sunyao-mmm/pynq-ecg-monitor/src/README.md

# Source

| 目录 | 用途 |
|---|---|
| `rtl/` | Verilog RTL 设计源码、AXI 寄存器、ADS1292 驱动和 XDC 约束 |

板端 Python 脚本放在 `board/`，仿真文件放在 `sim/`，避免把运行代码和 RTL 混在一起。
