sunyao-mmm/pynq-ecg-monitor/report/README.md

# Report

| 文件或目录 | 用途 |
|---|---|
| `design_report.docx` | 作品设计报告 |
| `ai_collaboration_source.md` | 大模型协作复盘、脱敏提示词、模型判断和人工验证摘录 |
| `evidence_appendix.md` | 测试矩阵、优化前后对比、时延拆分和 MIT-BIH 排除说明 |
| `performance/` | 时序、资源、检测和实时结果汇总 |
