sunyao-mmm/pynq-ecg-monitor/data/README.md

# Data

| 目录 | 用途 |
|---|---|
| `rom/` | 15 个 MIT-BIH 1024×16 COE、默认 208 的 HEX 回归文件、ROM 说明和生成脚本 |
| `mitbih/` | 批量验证脚本、运行日志和 Se/PPV 结果 |

`rom/` 用于 Vivado Block Memory Generator 初始化；`mitbih/` 用于算法离线验证，两者使用相同的数据缩放和重采样规则。
