sunyao-mmm/pynq-ecg-monitor/skill/vivado-report-audit/README.md

# Vivado Report Audit

| 文件或目录 | 用途 |
|---|---|
| `SKILL.md` | 适用场景、命令、验证结果和失效条件 |
| `scripts/check_reports.py` | 解析 timing/util 报告并输出 PASS/FAIL |
