sunyao-mmm/pynq-ecg-monitor/skill/fpga-agent-workflow/README.md

# FPGA Agent Workflow

| 文件或目录 | 用途 |
|---|---|
| `SKILL.md` | 人机协作调试的核心循环、适用边界和已验证效果 |
| `references/` | 提示词、案例模板和常见错误清单 |
