sunyao-mmm/pynq-ecg-monitor/skill/golden-signal-compare/README.md

# Golden Signal Compare

| 文件或目录 | 用途 |
|---|---|
| `SKILL.md` | 适用场景、容差规则、验证结果和失效条件 |
| `scripts/compare_intervals.py` | 对参考事件和检测事件做一对一匹配并计算 Se/PPV |
| `examples/` | record 100 的参考和检测峰值样例 |
