sunyao-mmm/pynq-ecg-monitor/skill/vivado-report-audit/scripts/README.md

# Scripts

| 文件 | 用途 |
|---|---|
| `check_reports.py` | 提取 WNS、WHS、失败端点、LUT、BRAM、DSP，并按阈值判断 |

最小示例见上级 `SKILL.md`。
