sunyao-mmm/pynq-ecg-monitor/skill/fpga-agent-workflow/references/README.md

# References

| 文件 | 用途 |
|---|---|
| `prompts.md` | 现象定位、版本差异、时序分析和输出验收提示词 |
| `case_template.md` | 一次问题从现象到回归的可复用记录模板 |
| `pitfalls.md` | FPGA/PYNQ 常见症状、优先检查和验证方法 |
