sunyao-mmm/pynq-ecg-monitor/skill/golden-signal-compare/scripts/README.md

# Scripts

| 文件 | 用途 |
|---|---|
| `compare_intervals.py` | 读取整数事件列表，在给定容差内做贪心一对一匹配 |

输入文件支持每行一个整数或逗号分隔整数。
