sunyao-mmm/pynq-ecg-monitor/skill/pynq-overlay-smoke/examples/README.md

# Examples

| 文件 | 用途 |
|---|---|
| `register_map.json` | `ecg_axil_0` 的寄存器偏移、期望 ID、测试值和运行位示例 |
| `minimal_register_map.json` | 非心电 AXI-Lite 项目的最小 SCRATCH 回读示例 |
| `validation_output.txt` | 无板卡模拟后端测试的原始通过输出 |

换项目时只修改 IP 名称和 JSON 中的寄存器描述，不需要改 Python 脚本。
