sunyao-mmm/pynq-ecg-monitor/skill/pynq-overlay-smoke/references/README.md

# References

| 文件 | 用途 |
|---|---|
| `troubleshooting.md` | 按症状列出 Overlay、IP、地址、时钟、复位和缓存问题的检查方法 |
