sunyao-mmm/pynq-ecg-monitor/report/performance/README.md

# Performance

| 文件 | 用途 |
|---|---|
| `performance_summary.md` | WNS/WHS、LUT/FF/BRAM/DSP、连续缓存、网页逻辑、MIT-BIH 和功能验证汇总 |
