sunyao-mmm/pynq-ecg-monitor/data/mitbih/verification_results.md

| 记录 | 标注心搏 | 检出TP | 漏检FN | 误检FP | Se(%) | PPV(%) | 参考时间轴可信 |
|---|---|---|---|---|---|---|---|
| 100 | 2273 | 2273 | 0 | 0 | 100.00 | 100.00 | ✅ |
| 101 | 1865 | 1861 | 4 | 6 | 99.79 | 99.68 | ✅ |
| 103 | 2084 | 2084 | 0 | 1 | 100.00 | 99.95 | ✅ |
| 105 | 2572 | 2557 | 15 | 14 | 99.42 | 99.46 | ✅ |
| 108 | 1763 | 1542 | 221 | 316 | 87.46 | 82.99 | ✅ |
| 111 | 2124 | 2121 | 3 | 4 | 99.86 | 99.81 | ✅ |
| 112 | 2539 | 2537 | 2 | 2 | 99.92 | 99.92 | ✅ |
| 114 | 643 | 128 | 515 | 1760 | 19.91 | 6.78 | ❌ 仅列出 |
| 116 | 2412 | 2393 | 19 | 3 | 99.21 | 99.87 | ✅ |
| 117 | 1535 | 1535 | 0 | 0 | 100.00 | 100.00 | ✅ |
| 118 | 2278 | 2274 | 4 | 5 | 99.82 | 99.78 | ✅ |
| 119 | 1987 | 1967 | 20 | 22 | 98.99 | 98.89 | ❌ 仅列出 |
| 121 | 1863 | 1853 | 10 | 12 | 99.46 | 99.36 | ❌ 仅列出 |
| 122 | 2476 | 2475 | 1 | 1 | 99.96 | 99.96 | ✅ |
| 123 | 1518 | 1516 | 2 | 1 | 99.87 | 99.93 | ✅ |
| 200 | 1565 | 780 | 785 | 1821 | 49.84 | 29.99 | ❌ 仅列出 |
| 208 | 2955 | 2737 | 218 | 30 | 92.62 | 98.92 | ✅ |
| 220 | 693 | 509 | 184 | 1534 | 73.45 | 24.91 | ❌ 仅列出 |
| 223 | 1689 | 1181 | 508 | 1422 | 69.92 | 45.37 | ❌ 仅列出 |
| 228 | 2053 | 1997 | 56 | 94 | 97.27 | 95.50 | ✅ |
| 230 | 797 | 227 | 570 | 2029 | 28.48 | 10.06 | ❌ 仅列出 |
| 233 | 2033 | 961 | 1072 | 2007 | 47.27 | 32.38 | ❌ 仅列出 |
| 234 | 2309 | 1750 | 559 | 999 | 75.79 | 63.66 | ❌ 仅列出 |
| **合计（仅可信记录）** | 30447 | 29902 | 545 | 477 | **98.21** | **98.43** | |
