sunyao-mmm/pynq-ecg-monitor/sim/testbench/tb_ecg_core.v

`timescale 1ns / 1ps
`default_nettype none
//==========================================================================
// tb_ecg_core.v -- round 1 of phase 2-2: the real ecg_core (ROM player + FIR
//                 + CLT + heart rate) driven with the 1024 MIT-BIH samples.
//
//   A behavioural ROM with 1 clock read latency stands in for the Block Memory
//   Generator that will sit in the block design.
//
//   expected: R peaks at input indices 77 / 370 / 663 / 947
//             bpm = 74 / 74 / 76 ,  beat_count = 4
//
//   CLK_PER_SAMPLE is set to 64 here (the board uses 277778) so the run is short.
//   ASCII only on purpose.
//==========================================================================
module tb_ecg_core;

    localparam integer NSAMP = 711;
    localparam integer CLKS  = 64;          // clocks per sample in this simulation

    reg clk = 1'b0;
    always #5 clk = ~clk;                   // 100 MHz

    reg  rst_n, run, soft_rst;
    reg  [31:0] cap_len_in;
    reg         src_sel;
    reg  signed [15:0] adc_sample;
    reg         adc_valid;
    wire [9:0]  rom_addr;
    reg  signed [15:0] rom_data;
    wire        cap_we;
    wire [11:0] cap_addr;
    wire [31:0] cap_data;
    wire [31:0] st_clt_now, st_r_index, st_rr_samples, st_beat_count, st_rr_bad_cnt;
    wire [15:0] st_r_amp, st_bpm;
    wire        st_cap_done;

    reg signed [15:0] mem [0:NSAMP-1];      // the behavioural ROM contents

    integer i, n_det, n_bpm, errs, checks;
    reg [31:0] det [0:31];
    reg [15:0] bpm_seen [0:7];
    integer exp_det [0:3];
    integer exp_bpm [0:3];

    // ---- behavioural ROM with 2 clock read latency (this is what the BMG
    //      summary reports, so we verify the worst case here) ----
    reg signed [15:0] rom_q1;
    always @(posedge clk) begin
        rom_q1   <= mem[rom_addr];
        rom_data <= rom_q1;
    end

    ecg_core #(.CLK_PER_SAMPLE(CLKS), .ROM_AW(10), .CAP_AW(12), .ROM_LEN(711), .SETTLE(0), .CAL_FIRST(0)) dut (
        .clk(clk), .rst_n(rst_n), .run(run), .soft_rst(soft_rst), .cap_len_in(cap_len_in),
        .src_sel(src_sel), .adc_sample(adc_sample), .adc_valid(adc_valid),
        .rom_addr(rom_addr), .rom_data(rom_data),
        .cap_we(cap_we), .cap_addr(cap_addr), .cap_data(cap_data),
        .st_clt_now(st_clt_now), .st_r_index(st_r_index), .st_r_amp(st_r_amp), .st_bpm(st_bpm),
        .st_rr_samples(st_rr_samples), .st_beat_count(st_beat_count),
        .st_rr_bad_cnt(st_rr_bad_cnt), .st_cap_done(st_cap_done)
    );

    // ---- the testbench acts like the ARM: it samples the status ports ----
    reg        clt_valid_d;
    reg        r_valid_d;      // r_valid one clock earlier (the cycle that was captured)

    // ---- capture format monitor: TWO 32-bit words per sample ----------------
    //   even word address : { 15'b0, r_valid, y[15:0] }   band-passed ECG + R flag
    //   odd  word address : clt_out                       CLT value
    integer cap_we_cnt, cap_w0_cnt, cap_w1_cnt, cap_clt_cnt, cap_fmt_errs;
    always @(posedge clk) begin
        clt_valid_d <= cap_we;                      // one capture write pulse
        r_valid_d   <= dut.u_det.r_valid;           // the flag that is being captured
        if (rst_n && dut.u_det.clt_valid) cap_clt_cnt = cap_clt_cnt + 1;
        if (rst_n && cap_we) begin
            cap_we_cnt = cap_we_cnt + 1;
            // NOTE: cap_we / cap_addr / cap_data are all registered on the same
            // edge, so the address seen here is already the NEXT one.  The word
            // that was just written therefore sits at (cap_addr - 1), i.e. the
            // waveform word shows up here when cap_addr is ODD.
            if (cap_addr[0] == 1'b1) begin          // waveform word (addr-1 even)
                cap_w0_cnt = cap_w0_cnt + 1;
                if (cap_data[15:0] !== dut.u_det.y) begin
                    cap_fmt_errs = cap_fmt_errs + 1;
                    if (cap_fmt_errs < 4)
                        $display("  FAIL capture wave word: got %0d  y = %0d",
                                 cap_data[15:0], dut.u_det.y);
                end
                if (cap_data[16] !== r_valid_d) begin
                    cap_fmt_errs = cap_fmt_errs + 1;
                    if (cap_fmt_errs < 4)
                        $display("  FAIL capture R flag: got %0d  r_valid = %0d",
                                 cap_data[16], r_valid_d);
                end
            end
            else begin                              // CLT word (addr-1 odd)
                cap_w1_cnt = cap_w1_cnt + 1;
                // 2026-10-18: CLT 字的最高字节现在放 LOFF_STAT（bit31 恒为 1），
                // 比较时只看低 24 位。
                if ((cap_data & 32'h00FF_FFFF) !== (dut.u_det.clt_out & 32'h00FF_FFFF)) begin
                    cap_fmt_errs = cap_fmt_errs + 1;
                    if (cap_fmt_errs < 4)
                        $display("  FAIL capture CLT word: got %0d  clt = %0d",
                                 cap_data, dut.u_det.clt_out);
                end
            end
        end
    end

    // monitor: catch the R peaks and the bpm updates the same way the PS would
    reg r_valid_prev;
    always @(posedge clk) r_valid_prev <= dut.u_det.r_valid;
    always @(posedge clk) begin
        if (rst_n && !r_valid_prev && dut.u_det.r_valid && n_det < 32) begin
            det[n_det] = dut.u_det.r_index;
            $display("  [%0t] R peak: index=%0d  amp=%0d", $time, dut.u_det.r_index, dut.u_det.r_amp);
            n_det = n_det + 1;
        end
        if (rst_n && dut.u_hr.bpm_valid && n_bpm < 8) begin
            bpm_seen[n_bpm] = dut.u_hr.bpm;
            $display("  [%0t] bpm = %0d   (rr = %0d samples)", $time, dut.u_hr.bpm, dut.u_hr.rr_samples);
            n_bpm = n_bpm + 1;
        end
    end

    task clear_stats;
        begin
            n_det = 0; n_bpm = 0;
            cap_we_cnt = 0; cap_w0_cnt = 0; cap_w1_cnt = 0;
            cap_clt_cnt = 0; cap_fmt_errs = 0;
            for (i = 0; i < 32; i = i + 1) det[i] = 32'd0;
            for (i = 0; i < 8;  i = i + 1) bpm_seen[i] = 16'd0;
        end
    endtask

    task check_all;
        integer k;
        begin
            $display("detected %0d R peaks (expect 4)", n_det);
            for (k = 0; k < 4; k = k + 1) begin
                checks = checks + 1;
                if (k < n_det && ($signed(det[k]) - $signed(exp_det[k])) <= 2 && ($signed(exp_det[k]) - $signed(det[k])) <= 2) $display("  ok   R peak[%0d] = %0d", k, det[k]);
                else begin
                    errs = errs + 1;
                    $display("  FAIL R peak[%0d] = %0d   (expect %0d)", k, det[k], exp_det[k]);
                end
            end
            $display("bpm updates: %0d (expect 3)", n_bpm);
            for (k = 0; k < 3; k = k + 1) begin
                checks = checks + 1;
                if (k < n_bpm && bpm_seen[k] === exp_bpm[k]) $display("  ok   bpm[%0d] = %0d", k, bpm_seen[k]);
                else begin
                    errs = errs + 1;
                    $display("  FAIL bpm[%0d] = %0d   (expect %0d)", k, bpm_seen[k], exp_bpm[k]);
                end
            end
            checks = checks + 1;
            if (st_beat_count === 32'd4) $display("  ok   st_beat_count = 4");
            else begin errs = errs + 1; $display("  FAIL st_beat_count = %0d (expect 4)", st_beat_count); end

            checks = checks + 1;
            if (($signed(st_rr_samples) - $signed(exp_det[3]-exp_det[2])) <= 2 && ($signed(exp_det[3]-exp_det[2]) - $signed(st_rr_samples)) <= 2) $display("  ok   st_rr_samples = %0d (last RR)", st_rr_samples);
            else begin errs = errs + 1; $display("  FAIL st_rr_samples = %0d (expect %0d)", st_rr_samples, exp_det[3]-exp_det[2]); end

            checks = checks + 1;
            if (st_cap_done === 1'b0) $display("  ok   st_cap_done = 0 (capture still running, buffer 4096 > 711)");
            else begin errs = errs + 1; $display("  FAIL st_cap_done = %0d", st_cap_done); end

            // ---- capture buffer format: 2 words per sample ----
            checks = checks + 1;
            if (cap_fmt_errs == 0 && cap_w0_cnt == cap_w1_cnt &&
                cap_we_cnt == 2*cap_clt_cnt && cap_w0_cnt > 0)
                $display("  ok   capture = %0d wave + %0d CLT words for %0d samples",
                         cap_w0_cnt, cap_w1_cnt, cap_clt_cnt);
            else begin
                errs = errs + 1;
                $display("  FAIL capture: we=%0d w0=%0d w1=%0d clt=%0d fmterr=%0d",
                         cap_we_cnt, cap_w0_cnt, cap_w1_cnt, cap_clt_cnt, cap_fmt_errs);
            end
        end
    endtask

    initial begin
        exp_det[0] = 54;  exp_det[1] = 258; exp_det[2] = 461; exp_det[3] = 658;
    // 2026-10-18: bpm 改为"最近 4 拍 RR 的中位数"，最后一拍 203->197 的小变化
    // 会被中位数平滑掉，读数是 74 而不是 76。这是预期的滤波行为。
    exp_bpm[0] = 74;  exp_bpm[1] = 74;  exp_bpm[2] = 74;  exp_bpm[3] = -1;

        mem[0] = -32'sd145;
        mem[1] = -32'sd145;
        mem[2] = -32'sd145;
        mem[3] = -32'sd145;
        mem[4] = -32'sd145;
        mem[5] = -32'sd145;
        mem[6] = -32'sd120;
        mem[7] = -32'sd145;
        mem[8] = -32'sd150;
        mem[9] = -32'sd160;
        mem[10] = -32'sd160;
        mem[11] = -32'sd175;
        mem[12] = -32'sd185;
        mem[13] = -32'sd170;
        mem[14] = -32'sd175;
        mem[15] = -32'sd180;
        mem[16] = -32'sd180;
        mem[17] = -32'sd155;
        mem[18] = -32'sd135;
        mem[19] = -32'sd190;
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
        mem[663] = -32'sd475;
        mem[664] = -32'sd390;
        mem[665] = -32'sd390;
        mem[666] = -32'sd410;
        mem[667] = -32'sd405;
        mem[668] = -32'sd385;
        mem[669] = -32'sd395;
        mem[670] = -32'sd405;
        mem[671] = -32'sd405;
        mem[672] = -32'sd400;
        mem[673] = -32'sd395;
        mem[674] = -32'sd410;
        mem[675] = -32'sd410;
        mem[676] = -32'sd395;
        mem[677] = -32'sd405;
        mem[678] = -32'sd405;
        mem[679] = -32'sd405;
        mem[680] = -32'sd390;
        mem[681] = -32'sd385;
        mem[682] = -32'sd395;
        mem[683] = -32'sd400;
        mem[684] = -32'sd400;
        mem[685] = -32'sd395;
        mem[686] = -32'sd395;
        mem[687] = -32'sd405;
        mem[688] = -32'sd400;
        mem[689] = -32'sd385;
        mem[690] = -32'sd375;
        mem[691] = -32'sd395;
        mem[692] = -32'sd390;
        mem[693] = -32'sd385;
        mem[694] = -32'sd385;
        mem[695] = -32'sd395;
        mem[696] = -32'sd385;
        mem[697] = -32'sd375;
        mem[698] = -32'sd385;
        mem[699] = -32'sd395;
        mem[700] = -32'sd390;
        mem[701] = -32'sd365;
        mem[702] = -32'sd375;
        mem[703] = -32'sd395;
        mem[704] = -32'sd380;
        mem[705] = -32'sd375;
        mem[706] = -32'sd380;
        mem[707] = -32'sd380;
        mem[708] = -32'sd375;
        mem[709] = -32'sd375;
        mem[710] = -32'sd375;

        rst_n = 1'b0; run = 1'b0; soft_rst = 1'b0; cap_len_in = 32'd4096;
        src_sel = 1'b0; adc_sample = 16'sd0; adc_valid = 1'b0;
        errs = 0; checks = 0;
        clear_stats;

        repeat (5) @(negedge clk);
        rst_n = 1'b1;
        repeat (3) @(negedge clk);
        run = 1'b1;

        $display("========== ecg_core : dual data source (ROM / ADS1292) ==========");
        $display("*** TB BUILD CORE-2 ***  (711 samples inlined, no .hex file needed)");

        // ---- phase 0 : ROM player ----
        repeat (NSAMP*CLKS + 4000) @(posedge clk);
        run = 1'b0;                          // stop the sample stream so the
        repeat (8) @(posedge clk);           // capture counters settle mid-pair
        $display("--- source 0 : ROM player ---");
        check_all;

        // ---- phase 1 : the same samples pushed in through the ADS1292 port ----
        clear_stats;
        src_sel = 1'b1;
        soft_rst = 1'b1; repeat (5) @(negedge clk); soft_rst = 1'b0;
        repeat (3) @(negedge clk);
        run = 1'b1;
        // 64 extra samples wrap round like the real ROM loop, so the last beat's
        // CLT can finish falling below half peak.
        for (i = 0; i < NSAMP+64; i = i + 1) begin
            @(negedge clk); adc_sample = (i < NSAMP) ? mem[i] : mem[i-NSAMP]; adc_valid = 1'b1;
            @(negedge clk); adc_valid = 1'b0;
            repeat (CLKS-2) @(negedge clk);
        end
        repeat (4000) @(posedge clk);
        run = 1'b0;
        repeat (8) @(posedge clk);
        $display("--- source 1 : ADS1292 port ---");
        check_all;

        $display("---------------------------------------------------------------------------");
        $display("checks = %0d   errors = %0d", checks, errs);
        if (errs == 0) $display("  RESULT: PASS");
        else           $display("  RESULT: FAIL");
        $display("===========================================================================");
        $finish;
    end

endmodule
`default_nettype wire
