sunyao-mmm/pynq-ecg-monitor/sim/testbench/tb_ecg_detect.v

`timescale 1ns / 1ps
`default_nettype none
//==========================================================================
// tb_ecg_detect.v -- self checking testbench for the FIR + CLT chain   (ECG-1)
//
//   input : 1024 samples of MIT-BIH record 100, lead MLII, inlined below
//           (uV, exactly the values of Desktop/ecg.coe)
//   truth : the MIT-BIH annotations inside that window: 77 / 370 / 662 / 946
//   each sample is applied with a 1 clock ce pulse every 64 clocks, so the
//   serial FIR (33 clocks) has plenty of time - just like the real 360 Hz rate.
//
//   expected result: 4 peaks detected, TP=4 FP=0 FN=0, and 960 y_valid pulses
//   (65 tap FIR -> the first 64 outputs are the start-up transient)
//
//   ASCII only on purpose.
//==========================================================================
module tb_ecg_detect;

    localparam integer NSAMP            = 775;
    localparam integer NTRUTH           = 4;
    localparam integer TOL              = 10;
    localparam integer CLKS_PER_SAMPLE  = 64;

    reg clk = 1'b0;
    always #5 clk = ~clk;                  // 100 MHz

    reg                rst_n;
    reg                ce;
    reg  signed [15:0] x;
    wire signed [15:0] y;
    wire               y_valid;
    wire signed [31:0] clt_out;
    wire               clt_valid;
    wire               r_valid;
    wire [31:0]        r_index;
    wire signed [15:0] r_amp;

    reg signed [15:0] stim  [0:NSAMP-1];
    integer           truth [0:NTRUTH-1];

    integer i, n_det, tp, fp, fn, n_yv, sei, ppvi;
    integer smin, smax;
    reg [31:0] det [0:63];
    reg        used [0:NTRUTH-1];
    reg [31:0] delta;
    reg        matched;
    reg signed [31:0] clt_max;

    ecg_detect_top #(
        .FIR_TAPS(65), .FIR_DELAY(32), .CLT_W(21), .C_CONST(2),
        .LEARN(30), .SEARCH(22), .REFRACT(50), .REL_PERIOD(250),
        .DATA_W(16), .ACC_W(32)
    ) dut (
        .clk(clk), .rst_n(rst_n), .ce(ce), .x(x), .settle_sel(16'd0), .cal_first(1'b0),
        .y(y), .y_valid(y_valid),
        .clt_out(clt_out), .clt_valid(clt_valid),
        .r_valid(r_valid), .r_index(r_index), .r_amp(r_amp)
    );

    always @(posedge clk) if (rst_n && y_valid) n_yv = n_yv + 1;
    always @(posedge clk) if (rst_n && clt_valid && (clt_out > clt_max)) clt_max = clt_out;

    always @(posedge clk) begin
        if (rst_n && r_valid && (n_det < 64)) begin
            det[n_det] = r_index;
            $display("  [%0t] R peak: input index=%0d  amp=%0d  clt=%0d",
                     $time, r_index, r_amp, clt_out);
            n_det = n_det + 1;
        end
    end

    initial begin
        rst_n = 1'b0; ce = 1'b0; x = 16'sd0;
        n_det = 0; tp = 0; fp = 0; fn = 0; n_yv = 0;
        clt_max = -1000000;
        for (i = 0; i < NTRUTH; i = i + 1) used[i] = 1'b0;
        for (i = 0; i < 64;     i = i + 1) det[i]  = 32'd0;

        // ---- stimulus inlined below: no .hex file needed ----
        stim[0] = -32'sd145;
        stim[1] = -32'sd145;
        stim[2] = -32'sd145;
        stim[3] = -32'sd145;
        stim[4] = -32'sd145;
        stim[5] = -32'sd145;
        stim[6] = -32'sd120;
        stim[7] = -32'sd145;
        stim[8] = -32'sd150;
        stim[9] = -32'sd160;
        stim[10] = -32'sd160;
        stim[11] = -32'sd175;
        stim[12] = -32'sd185;
        stim[13] = -32'sd170;
        stim[14] = -32'sd175;
        stim[15] = -32'sd180;
        stim[16] = -32'sd180;
        stim[17] = -32'sd155;
        stim[18] = -32'sd135;
        stim[19] = -32'sd190;
        stim[20] = -32'sd205;
        stim[21] = -32'sd225;
        stim[22] = -32'sd245;
        stim[23] = -32'sd260;
        stim[24] = -32'sd275;
        stim[25] = -32'sd275;
        stim[26] = -32'sd265;
        stim[27] = -32'sd255;
        stim[28] = -32'sd275;
        stim[29] = -32'sd290;
        stim[30] = -32'sd290;
        stim[31] = -32'sd290;
        stim[32] = -32'sd295;
        stim[33] = -32'sd305;
        stim[34] = -32'sd285;
        stim[35] = -32'sd275;
        stim[36] = -32'sd280;
        stim[37] = -32'sd305;
        stim[38] = -32'sd290;
        stim[39] = -32'sd280;
        stim[40] = -32'sd290;
        stim[41] = -32'sd315;
        stim[42] = -32'sd320;
        stim[43] = -32'sd335;
        stim[44] = -32'sd385;
        stim[45] = -32'sd385;
        stim[46] = -32'sd455;
        stim[47] = -32'sd485;
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
        stim[764] = -32'sd375;
        stim[765] = -32'sd375;
        stim[766] = -32'sd375;
        stim[767] = -32'sd375;
        stim[768] = -32'sd375;
        stim[769] = -32'sd375;
        stim[770] = -32'sd375;
        stim[771] = -32'sd375;
        stim[772] = -32'sd375;
        stim[773] = -32'sd375;
        stim[774] = -32'sd375;
        // ---- MIT-BIH annotations inside this window ----
        truth[0] = 32'sd53;
        truth[1] = 32'sd257;
        truth[2] = 32'sd460;
        truth[3] = 32'sd658;

        $display("=========== ecg_detect_top : FIR 5-40 Hz + CLT ===========");
        $display("*** TB BUILD ECG-1-3 ***  (1024 samples inlined, no .hex file needed)");
        smin = stim[0]; smax = stim[0];
        for (i = 0; i < NSAMP; i = i + 1) begin
            if (stim[i] < smin) smin = stim[i];
            if (stim[i] > smax) smax = stim[i];
        end
        $display("stimulus min/max = %0d / %0d   (expect -645 / 960)", smin, smax);
        $display("FIR group delay  = 32 input samples (88.9 ms), already added back into r_index");
        for (i = 0; i < NTRUTH; i = i + 1)
            $display("    truth[%0d] = %0d", i, truth[i]);

        repeat (10) @(negedge clk);
        rst_n = 1'b1;
        repeat (5) @(negedge clk);

        // Stimulus is driven on the FALLING edge, i.e. half a clock before the DUT
        // samples it.  Driving it on the rising edge (as the first version did) races
        // with the DUT sampling on that same edge: one simulator lets the testbench
        // win, another lets the DUT win.  ModelSim passed, xsim did not.
        for (i = 0; i < NSAMP; i = i + 1) begin
            @(negedge clk);
            x  = stim[i];
            ce = 1'b1;
            @(negedge clk);
            ce = 1'b0;
            repeat (CLKS_PER_SAMPLE-2) @(negedge clk);
        end
        repeat (200) @(posedge clk);

        // ---------------- score ----------------
        for (i = 0; i < n_det; i = i + 1) begin
            matched = 1'b0;
            for (fn = 0; fn < NTRUTH; fn = fn + 1) begin
                if (!matched && !used[fn]) begin
                    delta = (det[i] >= truth[fn]) ? (det[i] - truth[fn]) : (truth[fn] - det[i]);
                    if (delta <= TOL) begin
                        used[fn] = 1'b1; matched = 1'b1; tp = tp + 1;
                        $display("  TP: detected %0d  matched annotation %0d  (delta %0d)",
                                 det[i], truth[fn], delta);
                    end
                end
            end
            if (!matched) begin
                fp = fp + 1;
                $display("  FP: detected %0d has no annotation", det[i]);
            end
        end
        for (fn = 0; fn < NTRUTH; fn = fn + 1)
            if (!used[fn]) begin
                $display("  FN: missed annotation %0d", truth[fn]);
            end
        fn = 0;
        for (i = 0; i < NTRUTH; i = i + 1) if (!used[i]) fn = fn + 1;

        $display("-------------------------------------------------");
        $display("detected = %0d   annotations = %0d", n_det, NTRUTH);
        $display("TP = %0d   FP = %0d   FN = %0d", tp, fp, fn);
        if ((tp + fn) > 0) begin
            sei = (tp * 1000) / (tp + fn);
            $display("Se  (sensitivity) = %0d.%0d %%", sei/10, sei%10);
        end
        if ((tp + fp) > 0) begin
            ppvi = (tp * 1000) / (tp + fp);
            $display("PPV (precision)   = %0d.%0d %%", ppvi/10, ppvi%10);
        end
        $display("-------------------------------------------------");
        $display("  y_valid pulses (FIR outputs) = %0d   [expect 711]", n_yv);
        $display("  max CLT value                = %0d", clt_max);
        $display("=================================================");
        $finish;
    end

endmodule
`default_nettype wire
